pheonixfighter/PROJECT_HERBINATOR/Documentation/Herbinator Roadmap Review Template.pdf

Team Name: Electrodoom

Team Members: Landon, Robert, Jasmine, Zach, Juan, Hunter

Project Name: Herbinator

Version 1.0

Project Roadmap & Schedule Document

Timeline

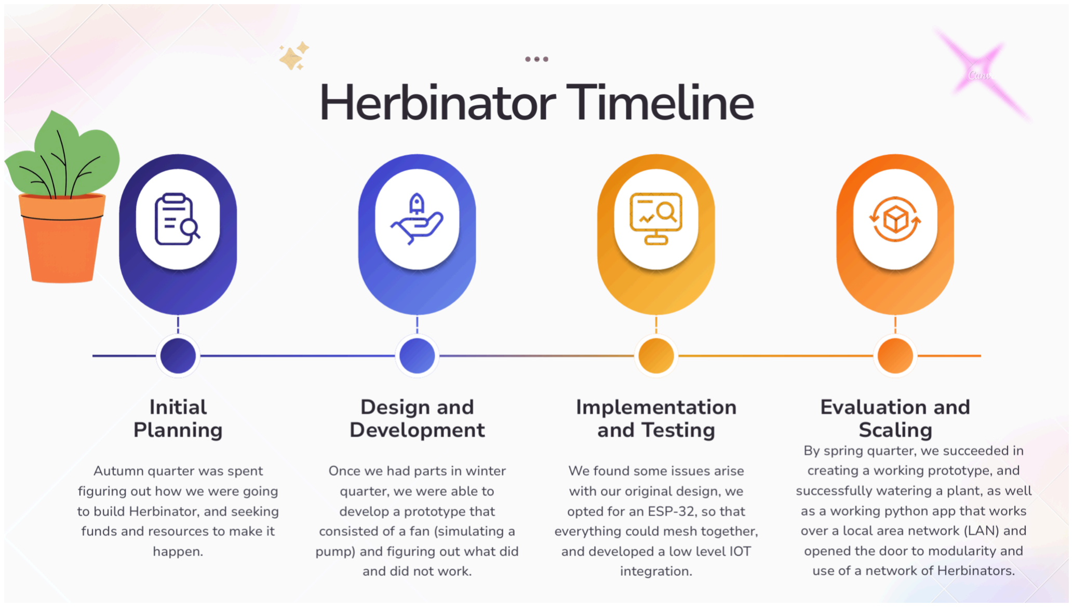
[picture p1: figure]
