pheonixfighter/PROJECT_HERBINATOR/PCB/HerbUnitPCB/LEDs/BlueLED/APT2012VBC_D.step

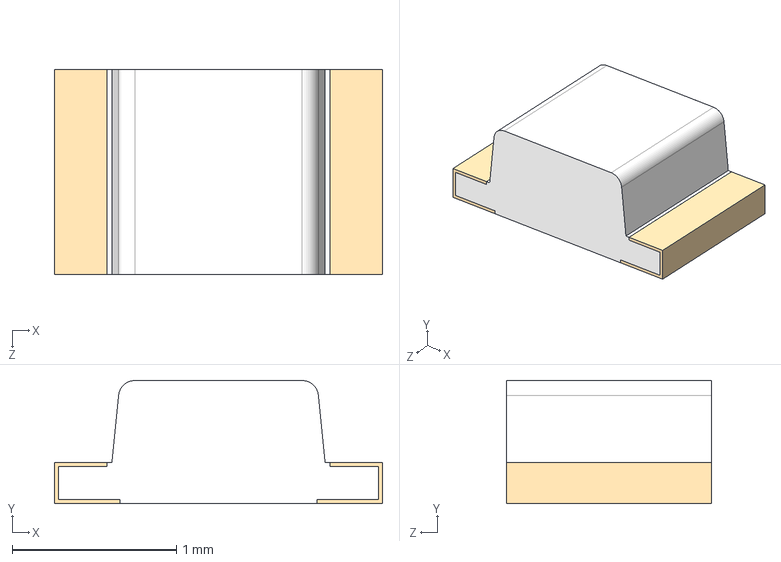
[picture p2: CAD file, 2026-06-17]
PCB/HerbUnitPCB/LEDs/BlueLED/APT2012VBC_D.step
2.00 x 0.75 x 1.25 mm
