pheonixfighter/PROJECT_HERBINATOR/PCB/HerbUnitPCB/Models/DM1AA-SF-PEJ(82).STEP

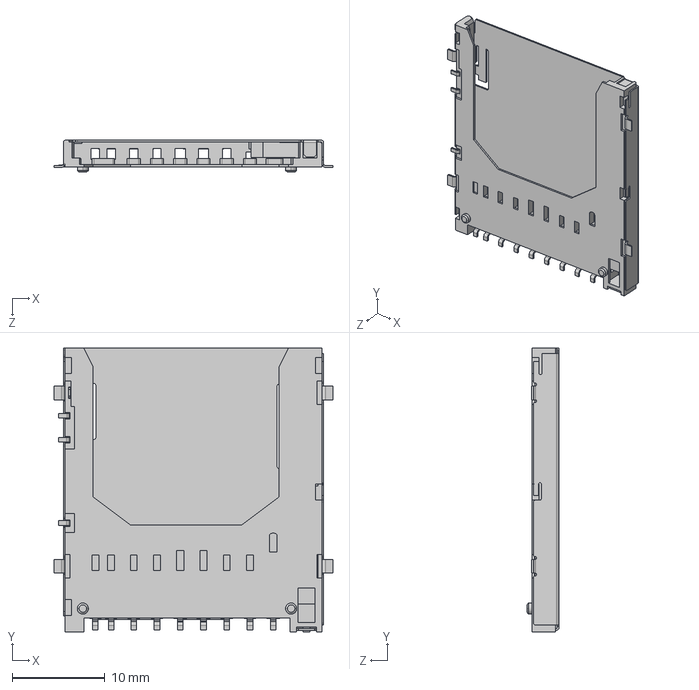
[picture p3: CAD file, 2026-05-25]
PCB/HerbUnitPCB/Models/DM1AA-SF-PEJ(82).STEP
30.0 x 30.5 x 3.45 mm
