pheonixfighter/PROJECT_HERBINATOR/PCB/HerbUnitPCB/HerbUnitPCB.kicad_pcb

## KiCad design PCB/HerbUnitPCB/HerbUnitPCB.kicad_pcb (2026-05-28)

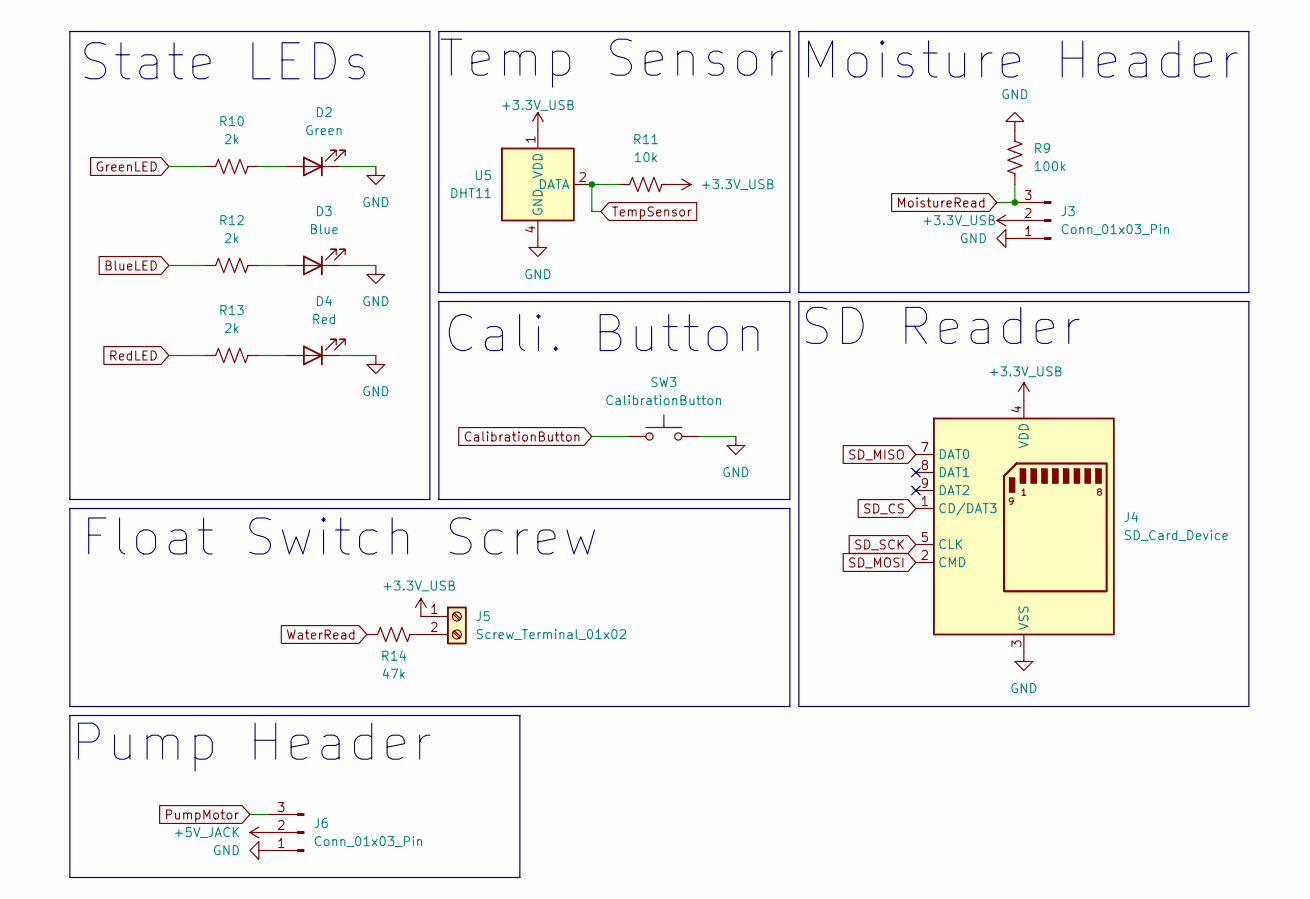
[picture p4: schematic peripherals.kicad_sch]

Parts:
D2: Green; LED_APT2012CGCK; MPN APT2012CGCK
D3: Blue; LED_APT2012VBC_D; MPN APT2012VBC_D
D4: Red; LED_APT2012EC; MPN APT2012EC
J3, J6: Conn_01x03_Pin; PinHeader_1x03_P2.54mm_Horizontal; MPN 61300311021
J4: SD_Card_Device; SD_Hirose_DM1AA_SF_PEJ82; MPN DM1AA-SF-PEJ(21)
J5: Screw_Terminal_01x02; TerminalBlock_Phoenix_MKDS-1,5-2-5.08_1x02_P5.08mm_Horizont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; MPN 1715721
R9: 100k; R_0805_2012Metric; MPN RC0805JR-07100KL
R10, R12, R13: 2k; R_0402_1005Metric; MPN AC0402FR-072KL
R11: 10k; R_0402_1005Metric; MPN RC0402FR-1310KL
R14: 47k; R_0805_2012Metric; MPN RT0805FRE0747KL
SW3: CalibrationButton; SW_Push_1P1T_NO_CK_PTS125Sx43SMTR; MPN PTS125SM43
U5: DHT11; Aosong_DHT11_5.5x12.0_P2.54mm; MPN DHT11

Connections:
+3.3V_USB: J3.2, J4.4 (VDD), J5.1, R11.2, U5.1 (VDD); also elsewhere on the board
+5V_JACK: J6.2; also elsewhere on the board
BlueLED: R12.1; also elsewhere on the board
CalibrationButton: SW3.1; also elsewhere on the board
GND: D2.1 (K), D3.1 (K), D4.1 (K), J3.1, J4.3 (VSS), J4.6 (VSS), J6.1, R9.2, SW3.2, U5.4 (GND); also elsewhere on the board
GreenLED: R10.1; also elsewhere on the board
MoistureRead: J3.3, R9.1; also elsewhere on the board
unnamed: D2.2 (A), R10.2
unnamed: D3.2 (A), R12.2
unnamed: D4.2 (A), R13.2
unnamed: J5.2, R14.2
PumpMotor: J6.3; also elsewhere on the board
RedLED: R13.1; also elsewhere on the board
SD_CS: J4.1 (CD/DAT3); also elsewhere on the board
SD_MISO: J4.7 (DAT0); also elsewhere on the board
SD_MOSI: J4.2 (CMD); also elsewhere on the board
SD_SCK: J4.5 (CLK); also elsewhere on the board
TempSensor: R11.1, U5.2 (DATA); also elsewhere on the board
WaterRead: R14.1; also elsewhere on the board

Notes on the sheet:
Float Switch Screw
Cali. Button
State LEDs
Moisture Header
Pump Header
Temp Sensor
SD Reader

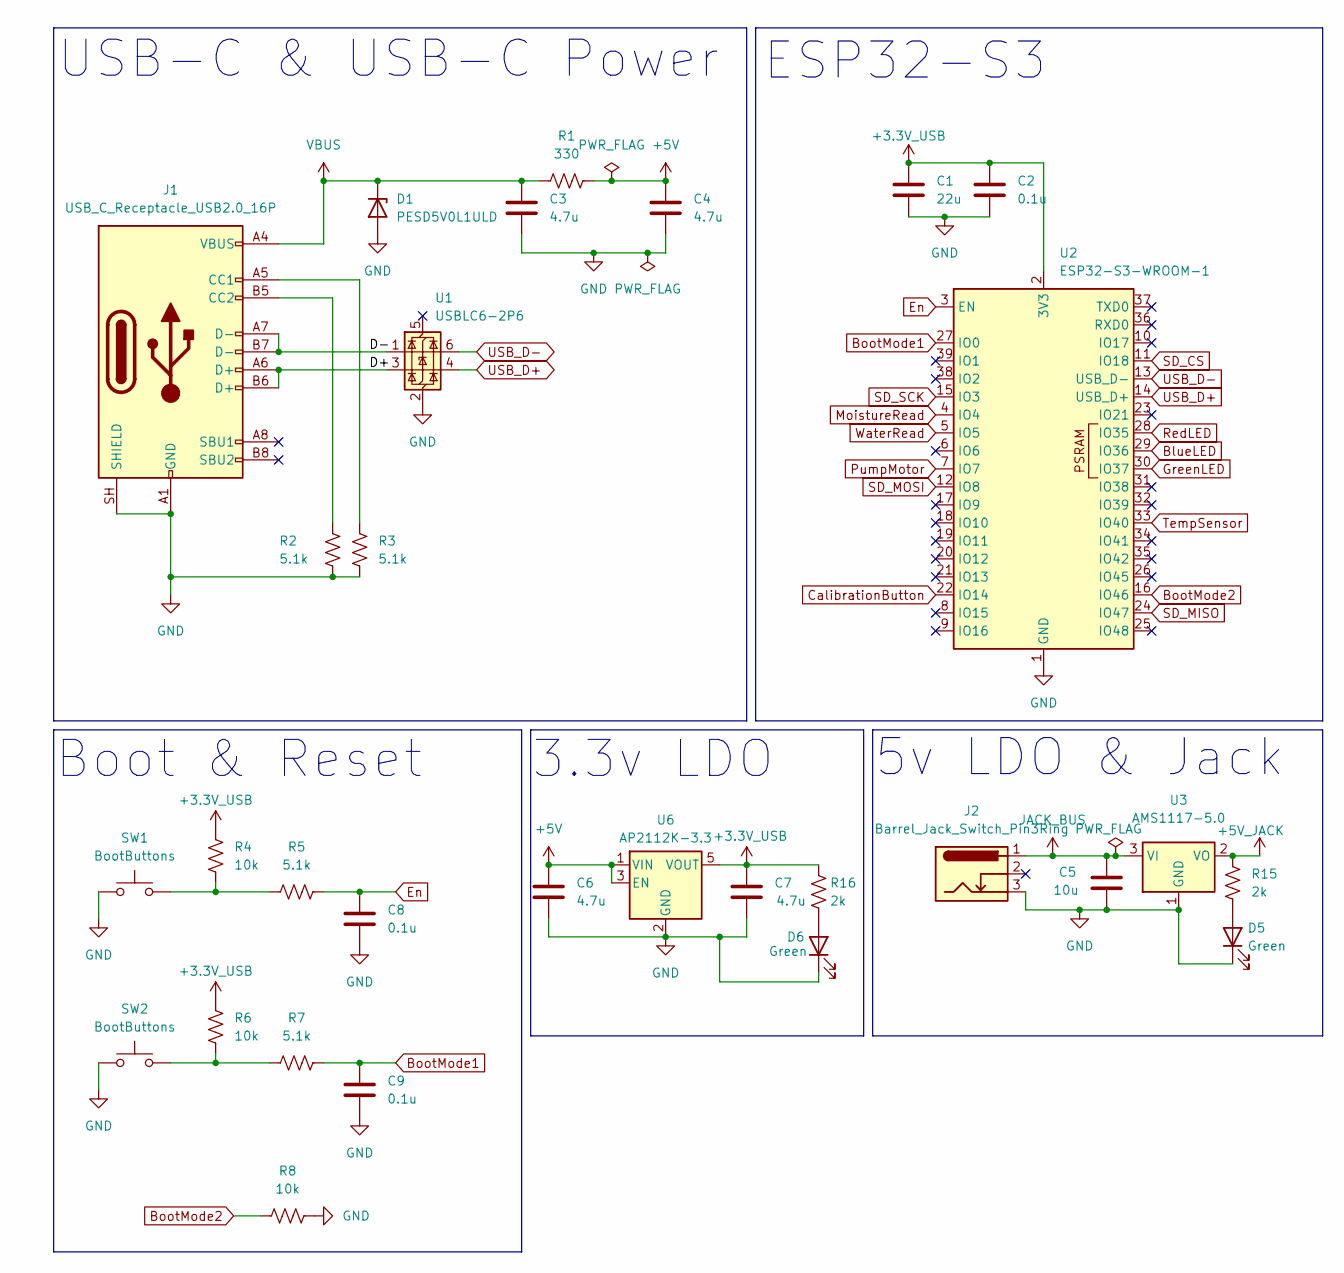
[picture p5: schematic ESP32_S3.kicad_sch]

Parts:
C1: 22u; C_0805_2012Metric; MPN GRM21BR61E226ME44K
C2, C8, C9: 0.1u; C_0402_1005Metric; MPN GRM155R62A104KE14D
C3, C4, C6, C7: 4.7u; C_0402_1005Metric; MPN GRM155R61A475MEAAD
C5: 10u; C_1206_3216Metric; MPN GRM319R61E106KA12D
D1: PESD5V0L1ULD; D_SOD-882D; MPN SOD882
D5, D6: Green; LED_APT2012CGCK
J1: USB_C_Receptacle_USB2.0_16P; USB_C_Receptacle_G-Switch_GT-USB-7010ASV; MPN UJ31-CH-3-SMT-TR
J2: Barrel_Jack_Switch_Pin3Ring; BarrelJack_Horizontal; MPN PJ-002A
R1: 330; R_0805_2012Metric; MPN RC0805FR-10330RL
R2, R3, R5, R7: 5.1k; R_0402_1005Metric; MPN RT0402DRE075K1L
R4, R6, R8: 10k; R_0402_1005Metric; MPN RC0402FR-1310KL
R15, R16: 2k; R_0402_1005Metric; MPN AC0402FR-072KL
SW1, SW2: BootButtons; SW_SPST_B3U-1000P; MPN B3U-1000P
U1: USBLC6-2P6; SOT-666; MPN USBLC6-2P6
U2: ESP32-S3-WROOM-1; MPN ESP32-S3-WROOM-1-N8
U3: AMS1117-5.0; SOT-223-3_TabPin2; MPN AMS1117-5.0(XBLW)
U6: AP2112K-3.3; SOT-23-5; MPN AP2112K-3.3TRG1

Connections:
+3.3V_USB: C1.1, C2.1, C7.1, R4.1, R6.1, R16.1, U2.2 (3V3), U6.5 (VOUT); also elsewhere on the board
+5V: C4.1, C6.1, R1.2, U6.1 (VIN), U6.3 (EN)
+5V_JACK: R15.1, U3.2 (VO); also elsewhere on the board
/ESP32-S3/D+: J1.A6 (D+), J1.B6 (D+), U1.3 (I/O2)
/ESP32-S3/D-: J1.A7 (D-), J1.B7 (D-), U1.1 (I/O1)
BlueLED: U2.29 (IO36); also elsewhere on the board
BootMode1: C9.1, R7.2, U2.27 (IO0)
BootMode2: R8.1, U2.16 (IO46)
CalibrationButton: U2.22 (IO14); also elsewhere on the board
En: C8.1, R5.2, U2.3 (EN)
GND: C1.2, C2.2, C3.2, C4.2, C5.2, C6.2, C7.2, C8.2, C9.2, D1.2 (A), D5.1 (K), D6.1 (K), J1.A1 (GND), J1.A12 (GND), J1.B1 (GND), J1.B12 (GND), J1.SH (SHIELD), J2.3, R2.1, R3.2, R8.2, SW1.1, SW2.1, U1.2 (GND), U2.1 (GND), U2.40 (GND), U2.41 (GND), U3.1 (GND), U6.2 (GND); also elsewhere on the board
GreenLED: U2.30 (IO37); also elsewhere on the board
JACK_BUS: C5.1, J2.1, U3.3 (VI)
MoistureRead: U2.4 (IO4); also elsewhere on the board
unnamed: D5.2 (A), R15.2
unnamed: D6.2 (A), R16.2
unnamed: J1.A5 (CC1), R3.1
unnamed: J1.B5 (CC2), R2.2
unnamed: R4.2, R5.1, SW1.2
unnamed: R6.2, R7.1, SW2.2
PumpMotor: U2.7 (IO7); also elsewhere on the board
RedLED: U2.28 (IO35); also elsewhere on the board
SD_CS: U2.11 (IO18); also elsewhere on the board
SD_MISO: U2.24 (IO47); also elsewhere on the board
SD_MOSI: U2.12 (IO8); also elsewhere on the board
SD_SCK: U2.15 (IO3); also elsewhere on the board
TempSensor: U2.33 (IO40); also elsewhere on the board
USB_D+: U1.4 (I/O2), U2.14 (USB_D+)
USB_D-: U1.6 (I/O1), U2.13 (USB_D-)
VBUS: C3.1, D1.1 (K), J1.A4 (VBUS), J1.A9 (VBUS), J1.B4 (VBUS), J1.B9 (VBUS), R1.1
WaterRead: U2.5 (IO5); also elsewhere on the board

Notes on the sheet:
ESP32-S3
5v LDO & Jack
3.3v LDO
Boot & Reset
USB-C & USB-C Power

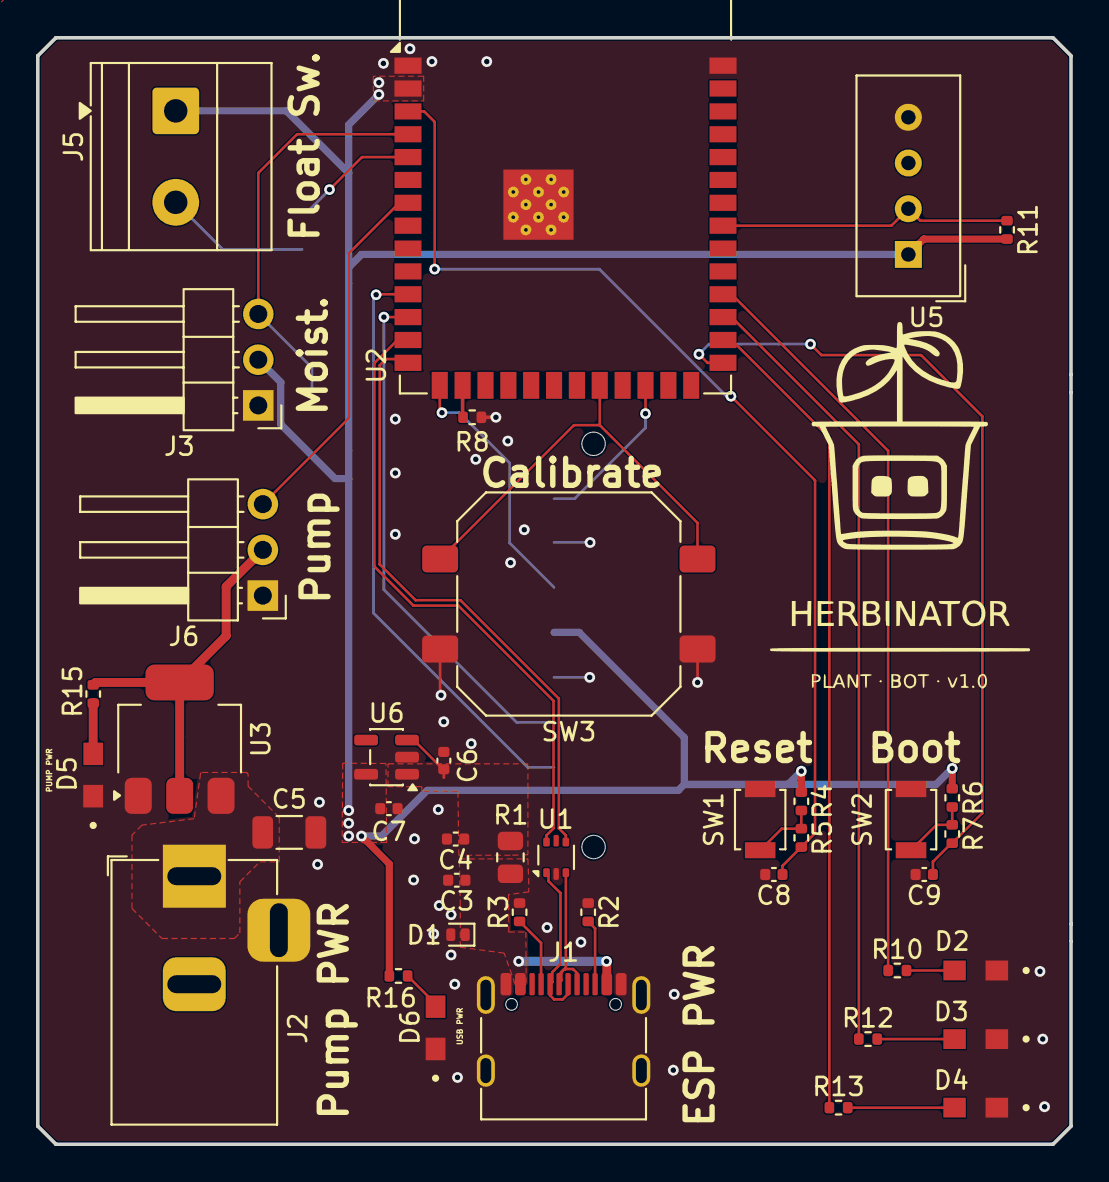
[picture p6: board HerbUnitPCB.kicad_pcb from above]

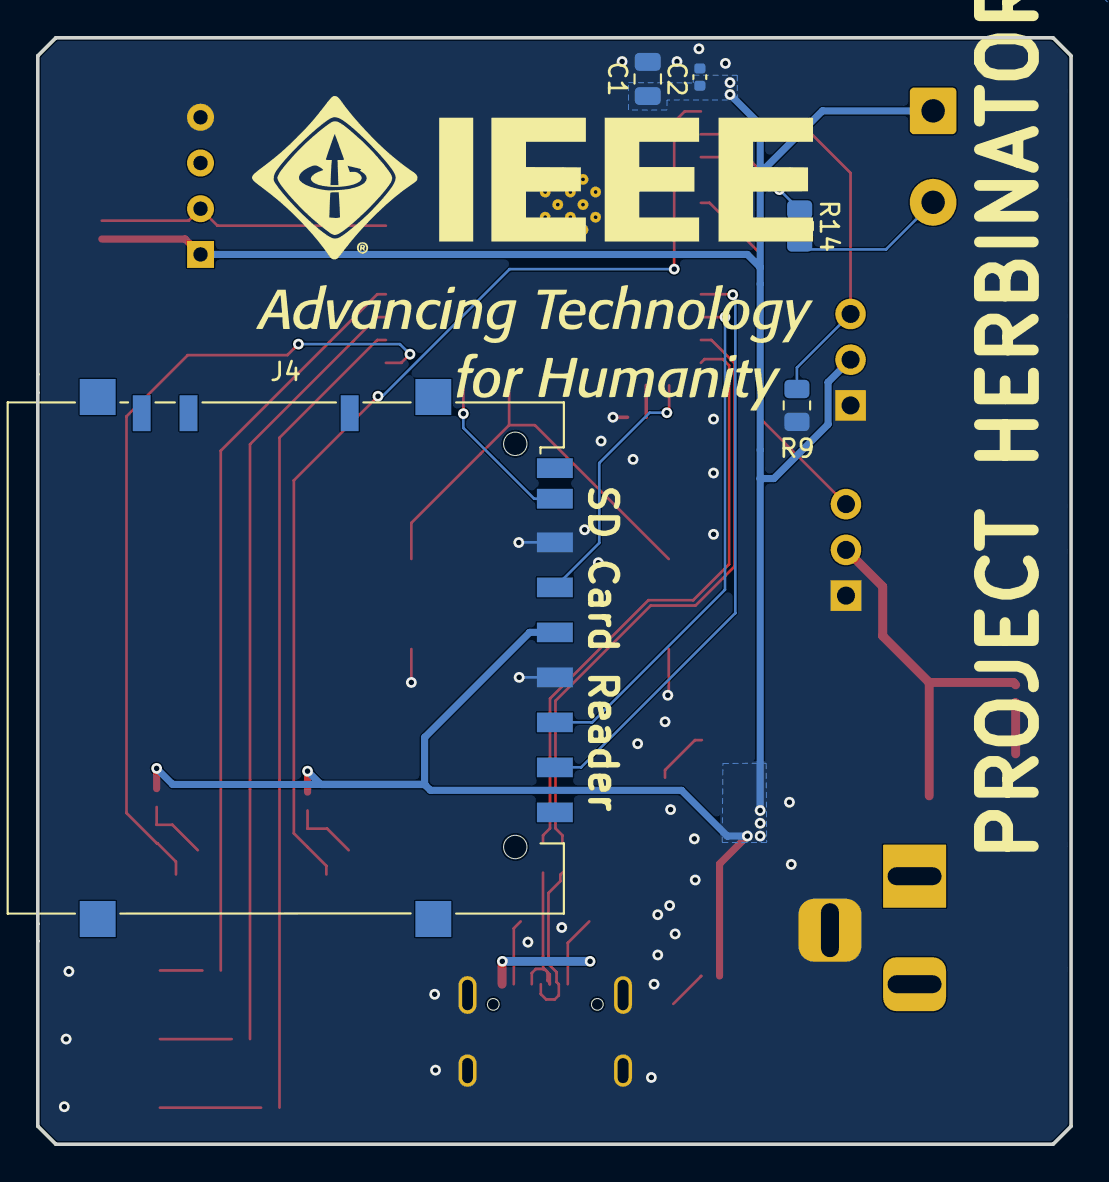
[picture p7: board HerbUnitPCB.kicad_pcb from below]

Board: 2 copper layers, 57.4 x 61.5 mm, 45 parts (5 on the bottom side), 35 nets.
