pheonixfighter/PROJECT_HERBINATOR/(commit log)

2026-05-12 PCB files added back
    [HerbUnitPCB.kicad_pcb, HerbUnitPCB.kicad_sch]
2026-05-14 Started PCB
    [ESP32_s3_chip.kicad_sch, HerbUnitPCB.kicad_sch, schematic_old.kicad_sch]
2026-05-23 Finished arrangement, fixed silkscreen
    [ESP32_S3.kicad_sch, HerbUnitPCB.kicad_pcb, peripherals.kicad_sch]
2026-05-25 PCB Routed + Silkscreen
    [DM1AA-SF-PEJ(82).STEP, ESP32_S3.kicad_sch, HerbUnitPCB.kicad_pcb, peripherals.kicad_sch]
2026-05-25 Started fabrication files
    [HerbUnitPCB-B_Cu.gbr, HerbUnitPCB-B_Mask.gbr, HerbUnitPCB-B_Paste.gbr, HerbUnitPCB-B_Silkscreen.gbr, HerbUnitPCB-Edge_Cuts.gbr, HerbUnitPCB-F_Cu.gbr, HerbUnitPCB-F_Mask.gbr, HerbUnitPCB-F_Paste.gbr]
2026-05-27 New Gerber
    [HerbUnitPCB-B_Cu.gbr, HerbUnitPCB-B_Mask.gbr, HerbUnitPCB-B_Paste.gbr, HerbUnitPCB-B_Silkscreen.gbr, HerbUnitPCB-Edge_Cuts.gbr, HerbUnitPCB-F_Cu.gbr, HerbUnitPCB-F_Mask.gbr, HerbUnitPCB-F_Paste.gbr]
2026-05-28 Updated BOM to have all parts.
    [ESP32_S3.kicad_sch, HerbUnitPCB.kicad_pcb, peripherals.kicad_sch]
2026-06-19 Update calibration button yield status to N/A
